kudep/Diplom_Accommodometer/annotation.tex

\likechapter{Аннотация}

В  выпускной  квалификационной  работе рассмотрено проектирование автоматизированной системы измерения и тренировки аккомодации глаз. Целью работы является создание системы, которая вкупе с законченной конструкционной базой, будет конкурентноспособоным прибором на рынке целевой аудитории. В начале осветим общие понятия, поставим задачу, далее рассмотрим имеющиеся выбор компонентов, сформируем компонентную базу, в последующей главе представлены электрические схемы и в конце работы приведем алгоритмическую часть функциональных частей операционной системы, представленных в графах.
