kudep/Diplom_Accommodometer/title.tex

\begin{titlepage}
\newpage

\begin{center}
МИНИСТЕРСТВО ОБРАЗОВАНИЯ И НАУКИ РОССИЙСКОЙ ФЕДЕРАЦИИ 
ФЕДЕРАЛЬНОЕ ГОСУДАРСТВЕННОЕ АВТОНОМНОЕ ОБРАЗОВАТЕЛЬНОЕ 
УЧРЕЖДЕНИЕ \\*
\vspace{1em}
«Национальный исследовательский ядерный университет «МИФИ»\\*
\hrulefill
\end{center}

\vspace{0.5em}

\begin{center}
 
Факультет очно-заочного (вечернего) обучения\\
Кафедра 27\\
«Микро- и наноэлектроники»\\
\end{center}

\vspace{0.5em}

\begin{center}
ПОЯСНИТЕЛЬНАЯ ЗАПИСКА\\
к выпускной квалификационной работе\\
по направлению 140800 – Ядерные физика и технологии\\
на тему:
\end{center}

\vspace{0.5em}

\begin{center}
\textsc{Автоматизированная система измерения и тренировки аккомодации глаз}
\end{center}

\vspace{1em}
 
\begin{center}

Студент:\hspace{3.45cm} \underline{\hspace{6cm}} \hspace{\fill}(\_Кузнецов Д.П.\_)\\ 
\vspace{1em}
 
Руководитель:\hspace{2.2cm} \underline{\hspace{6cm}} \hspace{\fill}(\_Саруханов В.А.\_)\\  
\vspace{1em}
 
Рецензент:\hspace{3.05cm} \underline{\hspace{6cm}} \hspace{\fill}(\_Коблов К.Ю.\_)\\ 
\vspace{1em}
 
Заведующий кафедрой:\hspace{0.2cm} \underline{\hspace{6cm}} \hspace{\fill}(\_Першенков В.С\_)\\ 
\vspace{1em}
 
Оценка ГЭК\hspace{2.65cm} \underline{\hspace{6cm}} \hspace{\fill}(\underline{\hspace{4cm}})\\
\begin{footnotesize}
\hspace{\fill}\underline{\hspace{0.3cm}}расшифровка подписи\underline{\hspace{0.3cm}}\\
\end{footnotesize}
Секретарь ГЭК\hspace{2.05cm} \underline{\hspace{6cm}} \hspace{\fill}(\underline{\hspace{4cm}})\\ 

\begin{footnotesize}
\hspace{\fill}\underline{\hspace{0.3cm}}расшифровка подписи\underline{\hspace{0.3cm}}\\
\end{footnotesize}

\end{center}
 
\vspace{\fill}

\begin{center}
\today
\end{center}

\begin{center}
Москва
\end{center}

\end{titlepage}
