kudep/Diplom_Accommodometer/pendant_A.tex

\likechapter{Приложение А}

\begin{figure}[ht]
	\centering
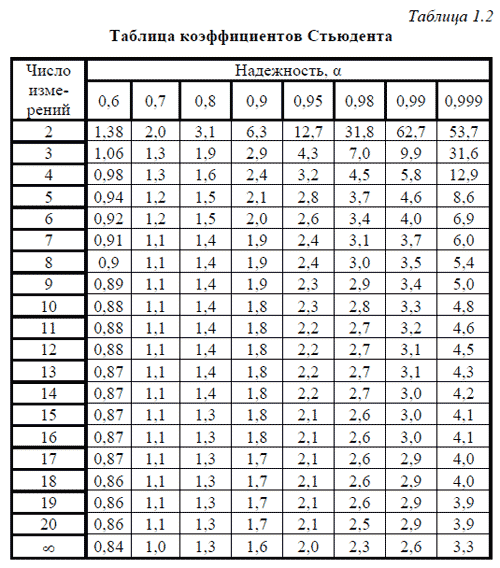
[picture p1: images/student_table.png]
	
	\caption{Таблица коэффициентов Стьюдента.}
	\label{fig:TestObjC}
\end{figure}
\includepdf[pages=1-2,scale=2.035,offset=0mm 0mm,pagecommand={}]{BoardSchem.pdf}
