kudep/Diplom_Accommodometer/Aut_Sys_M_T_Acc_Eyes.tex

\include{preamble}

\begin{document}

\include{title}

\include{annotation}

\newpage\tableofcontents % это 1оглавление, которое генерируется автоматически

\include{glossary}

\include{introduction}

\include{lit_review}

\include{component_base}

\include{hardware}

\include{OS}

\include{end}

\bibliographystyle{utf8gost705u}  %% стилевой файл для оформления по ГОСТу
\bibliography{biblio}     %% имя библиографической базы (bib-файла)

\include{pendant_A}

\include{pendant_B}

\end{document}
