kudep/Diplom_Accommodometer/end.tex

\likechapter{Заключение}
В результате дипломной работы была создана автоматизированная система измерения и тренировки аккомодации глаз. В рамках дипломной работы поставленная задача выполнена, по мере ее создания было использовано много интересных решений (подавление помех сигнала энкодера, создание напряжение для передачи сигнала цвета VGA, организация ОС и т.д.). При углублении в тему проекта со стороны заказчика было встречено и принято несколько расширяющих задач (подключение USB HUB, отображение на мониторе тест-картинок и т.д.).

На данном этапе заказчик создает для разработанной системы конструкцию, которая заменит макетную платформу, в тоже время идет отладка программного обеспечения и разработка печатной платы и решение других задач, нацеленные на приведение проекта к завершающей стадии готового продукта.
