kudep/Diplom_Accommodometer/pendant_B.tex

\likechapter{Приложение В}

Приведен класс с помощью которого создаются элементы графического интерфейса.
\begin{verbatim}

#ifndef CNTRLSUBGROUP_H_INCLUDED
#define CNTRLSUBGROUP_H_INCLUDED
#include <VGA.h>
#include <string.h>
#include "intrfsubgroup.h"

class CntrlSubGroup
{
public:
	CntrlSubGroup(Color_Style style, Metric_Parameters metric) 
	:ISG(IntrfSubGroup_Init_Parameters(style, metric, &state, text)), 
	metric(metric), state(false), modification(false){};
	CntrlSubGroup(Color_Style style, Metric_Parameters metric, 
	const char*_text) :ISG(IntrfSubGroup_Init_Parameters(style,
	 metric, &state, text)), metric(metric), state(false), 
	 modification(false){ strcpy_center_text(_text); };
	CntrlSubGroup(Color_Style style, Metric_Parameters metric, 
	int _text) :ISG(IntrfSubGroup_Init_Parameters(style, metric, 
	&state, text)), metric(metric), state(false), modification(false)
	{ strcpy_center_text(_text); };
	CntrlSubGroup();
	~CntrlSubGroup();
	void refresh();
	void update();
	bool strcpy_center_text(const char* _text);
	bool strcpy_center_text(int _ntext);
	bool strcpy_text(const char* _text);
	bool strcpy_text(int _ntext);
	void enable();
	void disable();
	void state_switch();

private:
	void add_space(int n);
	void itoa(int n, char s[]);
	void reverse(char s[]);
	static const int string_length = 30;
	IntrfSubGroup ISG;
	Metric_Parameters metric;
	IntrfSubGroup_State state;
	char text[string_length];
	bool modification;
};
#endif

#include"cntrlsubgroup.h"

CntrlSubGroup::CntrlSubGroup()
{
}

CntrlSubGroup::~CntrlSubGroup()
{
}
void CntrlSubGroup::refresh()
{
	ISG.update();
	modification = false;
}
void CntrlSubGroup::update()
{
	if (modification)ISG.update();
	modification = false;
}
bool CntrlSubGroup::strcpy_center_text(const char*_text)
{
	if (metric.height*metric.width > strlen(_text))
	{
		if (metric.height == 1)
		{
			add_space((metric.width - strlen(_text)) / 2);
			strcat(text, _text);
		}
		else
			strcpy(text, _text);
		modification = true;
		return true;
	}
	else
		return false;
}
bool CntrlSubGroup::strcpy_center_text(int _ntext)
{
	char _text[string_length];
	itoa(_ntext, _text);
	if (metric.height*metric.width > strlen(_text) + 1)
	{
		if (metric.height == 1)
		{
			add_space((metric.width - strlen(_text)) / 2);
			strcat(text, _text);
		}
		else
			strcpy(text, _text);
		modification = true;
		return true;
	}
	else
		return false;
}
bool CntrlSubGroup::strcpy_text(const char*_text)
{
	if (metric.height*metric.width > strlen(_text))
	{
		strcpy(text, _text);
		modification = true;
		return true;
	}
	else
		return false;
}
bool CntrlSubGroup::strcpy_text(int _ntext)
{
	char _text[string_length];
	itoa(_ntext, _text);
	if (metric.height*metric.width > strlen(_text)) 
	{
		strcpy(text, _text);
		modification = true;
		return true;
	}
	else
		return false;
}
void CntrlSubGroup::enable()
{
	state.enable();
	modification = true;
}
void CntrlSubGroup::disable()
{
	state.disable();
	modification = true;
}
void CntrlSubGroup::state_switch()
{
	state.reverse();
	modification = true;
}
void CntrlSubGroup::add_space(int n)
{
	for (size_t i = 0; i < n; i++)
		text[i] = ' ';
	text[n] = 0;
}
void CntrlSubGroup::itoa(int n, char s[])
{
	int i, sign;

	if ((sign = n) < 0)  /* записываем знак */
		n = -n;          /* делаем n положительным числом */
	i = 0;
	do {       /* генерируем цифры в обратном порядке */
		s[i++] = n % 10 + '0';   /* берем следующую цифру */
	} while ((n /= 10) > 0);     /* удаляем */
	if (sign < 0)
		s[i++] = '-';
	s[i] = '\0';
	reverse(s);
}
void CntrlSubGroup::reverse(char s[])
{
	int i, j;
	char c;

	for (i = 0, j = strlen(s) - 1; i<j; i++, j--) {
		c = s[i];
		s[i] = s[j];
		s[j] = c;
	}
}
\end{verbatim}
