kudep/Diplom_Accommodometer/preamble.tex

\documentclass[a4paper,14pt,russian]{extreport}
 
\usepackage{extsizes}
\usepackage{cmap} % для кодировки шрифтов в pdf
\usepackage[T2A]{fontenc}
\usepackage[utf8]{inputenc}
\usepackage[russian]{babel}
%\usepackage{pscyr}
  
\usepackage{graphicx} % для вставки картинок

%Поворачиваем рисунок вместе с подписью на 90 гр.:
\usepackage{rotating} 
\usepackage{epsfig}

\usepackage{amssymb,amsfonts,amsmath,amsthm} % математические дополнения от АМС
\usepackage{indentfirst} % отделять первую строку раздела абзацным отступом тоже
\usepackage[usenames,dvipsnames]{color} % названия цветов
\usepackage{makecell}
\usepackage{multirow} % улучшенное форматирование таблиц
\usepackage{ulem} % подчеркивания
 
\linespread{1.3} % полуторный интервал
%\renewcommand{\rmdefault}{ftm} % Times New Roman
\frenchspacing

%Форматирование подписей таблиц и картинок
\usepackage[tableposition=top]{caption}
\usepackage{subcaption}
\DeclareCaptionLabelFormat{gostfigure}{Рисунок #2}
\DeclareCaptionLabelFormat{gosttable}{Таблица #2}
\DeclareCaptionLabelSeparator{gost}{~---~}
\captionsetup{labelsep=gost}
\captionsetup[figure]{labelformat=gostfigure}
\captionsetup[table]{labelformat=gosttable}
\renewcommand{\thesubfigure}{\asbuk{subfigure}}
\graphicspath{{images/}}

%Форматирование заголовков
\usepackage{titlesec}
 
\titleformat{\chapter}[display]
    {\filcenter}
    {\MakeUppercase{\chaptertitlename} \thechapter}
    {8pt}
    {\bfseries}{}
 
\titleformat{\section}
    {\normalsize\bfseries}
    {\thesection}
    {1em}{}
 
\titleformat{\subsection}
    {\normalsize\bfseries}
    {\thesubsection}
    {1em}{}
 
% Настройка вертикальных и горизонтальных отступов
\titlespacing*{\chapter}{0pt}{-30pt}{8pt}
\titlespacing*{\section}{\parindent}{*4}{*4}
\titlespacing*{\subsection}{\parindent}{*4}{*4}

%Настройки страниц
\usepackage{geometry}
\geometry{left=3cm}
\geometry{right=1.5cm}
\geometry{top=2.4cm}
\geometry{bottom=2.4cm}

%Настройка списков
\usepackage{enumitem}
\makeatletter
    \AddEnumerateCounter{\asbuk}{\@asbuk}{м)}
\makeatother
\setlist{nolistsep}
\renewcommand{\labelitemi}{-}
\renewcommand{\labelenumi}{\asbuk{enumi})}
\renewcommand{\labelenumii}{\arabic{enumii})}

%Настройка оглавления
\usepackage{tocloft}
\renewcommand{\cfttoctitlefont}{\hspace{0.38\textwidth} \bfseries\MakeUppercase}
\renewcommand{\cftbeforetoctitleskip}{-1em}
\renewcommand{\cftaftertoctitle}{\mbox{}\hfill \\ \mbox{}\hfill{\footnotesize Стр.}\vspace{-2.5em}}
\renewcommand{\cftchapfont}{\normalsize\bfseries \MakeUppercase{\chaptername} }
\renewcommand{\cftsecfont}{\hspace{31pt}}
\renewcommand{\cftsubsecfont}{\hspace{11pt}}
\renewcommand{\cftbeforechapskip}{1em}
\renewcommand{\cftparskip}{-1mm}
\renewcommand{\cftdotsep}{1}
\setcounter{tocdepth}{2} % задать глубину оглавления — до subsection включительно

%Библиотека позволяющая выполнять подсчет страниц
%\usepackage(lastpage)

%Специальные разделы (аннотация, вступление, список сокращений, выводы, список литературы)
%Мы не ищем легких путей. Я решил создать свой собственный вид секции. Как оказалось, это не так-то и сложно.
%Чтобы определить секцию (я назвал её likechapter), для начала стоит определить соответствующую оформляющую команду. Оформить центрирование и капитализацию названия секции — раз плюнуть. Что я и сделал — команда \likechapterheading печатает как надо переданное ей название секции.
\newcommand{\empline}{\mbox{}\newline}
\newcommand{\likechapterheading}[1]{ 
	\newpage
    \begin{center}
    \textbf{\MakeUppercase{#1}}
    \end{center}
    \empline}
    
% определение заголовка \likechapter    
\makeatletter
    \renewcommand{\@dotsep}{2}
    \newcommand{\l@likechapter}[2]{{\bfseries\@dottedtocline{0}{0pt}{0pt}{#1}{#2}}}
\makeatother
\newcommand{\likechapter}[1]{    
    \likechapterheading{#1}    
    \addcontentsline{toc}{likechapter}{\MakeUppercase{#1}}}

% Список литературы   
\usepackage[square,numbers,sort&compress]{natbib}
\renewcommand{\bibnumfmt}[1]{#1.\hfill} % нумерация источников в самом списке — через точку
\renewcommand{\bibsection}{\likechapter{Список литературы}} % заголовок специального раздела
\setlength{\bibsep}{0pt}

%Вставк pdf файлов
\usepackage{pdfpages}
\newcommand{\append}[1]{ 
    \clearpage
    \stepcounter{chapter}    
    \paragraph{\MakeUppercase{#1}}
   \empline
    \addcontentsline{toc}{likechapter}{\MakeUppercase{\chaptertitlename~\Asbuk{chapter}\;#1}}}
