kudep/Diplom_Accommodometer/images/apparats_shcem_of_sys_graf.jpg

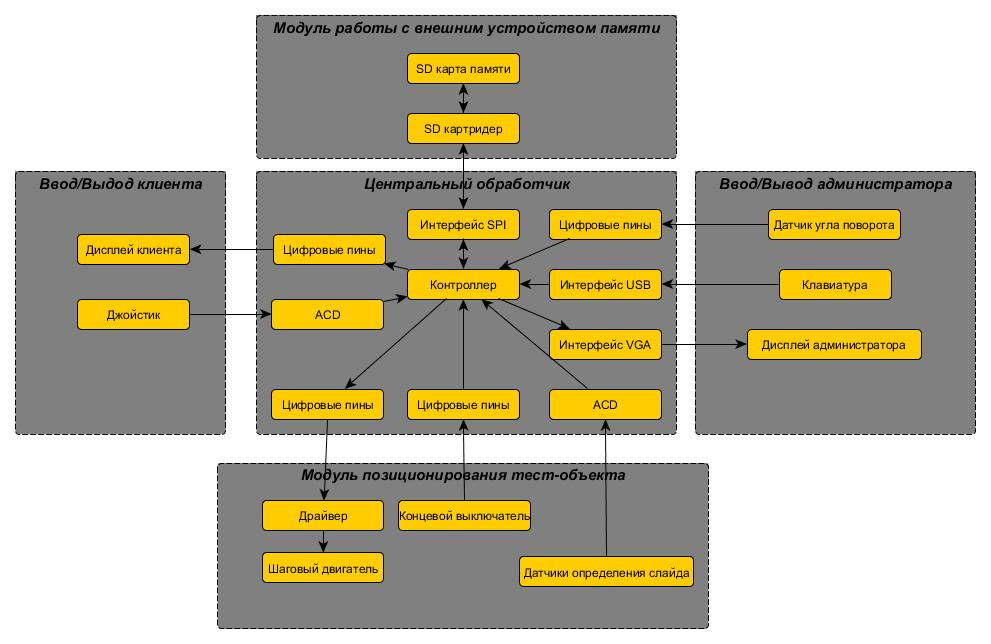
images/apparats_shcem_of_sys_graf.jpg
