kudep/Diplom_Accommodometer/BoardSchem.pdf

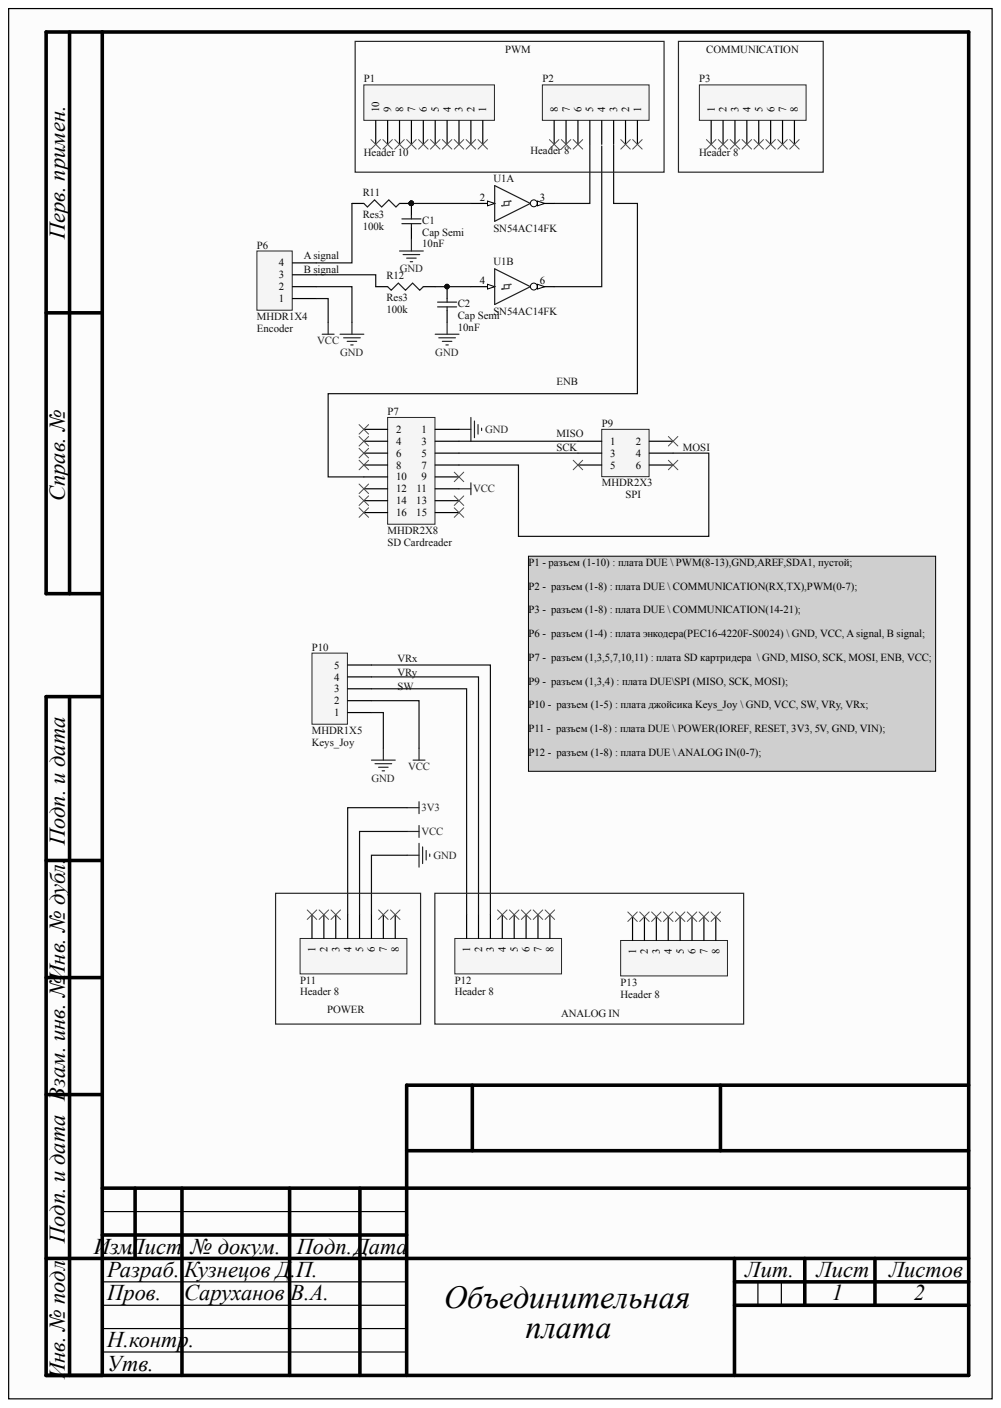
[picture p36: page 1]

Подп. и дата Перв. примен. Справ. №

Р1 - разъем (1-10) : плата DUE \ PWM(8-13),GND,AREF,SDA1, пустой;

Р2 - разъем (1-8) : плата DUE \ COMMUNICATION(RX,TX),PWM(0-7);

Р3 - разъем (1-8) : плата DUE \ COMMUNICATION(14-21);

Р6 - разъем (1-4) : плата энкодера(PEC16-4220F-S0024) \ GND, VCC, A signal, B signal;

Р7 - разъем (1,3,5,7,10,11) : плата SD картридера \ GND, MISO, SCK, MOSI, ENB, VCC;

Р9 - разъем (1,3,4) : плата DUE\SPI (MISO, SCK, MOSI);

Р10 - разъем (1-5) : плата джойсика Keys_Joy \ GND, VCC, SW, VRy, VRx;

Р11 - разъем (1-8) : плата DUE \ POWER(IOREF, RESET, 3V3, 5V, GND, VIN);

Р12 - разъем (1-8) : плата DUE \ ANALOG IN(0-7);

бл. Подп. и дата Взам. инв. №

Инв. № подл. Инв. № ду

Разраб. | Кузнецов Д.П. | Объединительная плата | Лит. | Лист | Листов
Пров. | Саруханов В.А. | | | | | 1 | 2

Н.контр.
Утв.

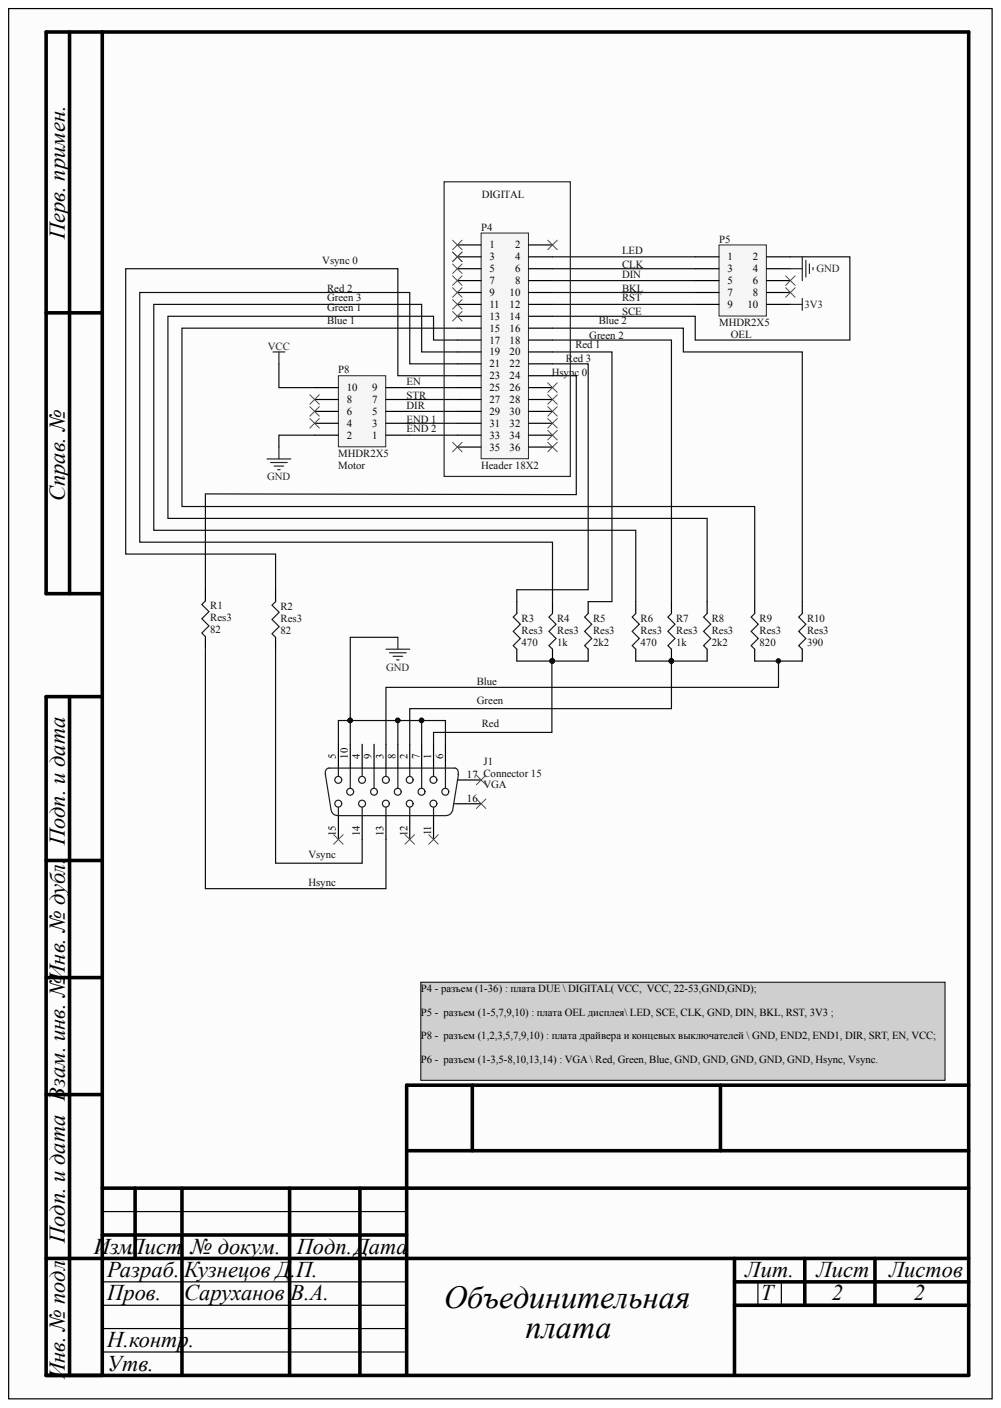
[picture p37: page 2]

Подп. и дата Перв. примен. Справ. №

CLK
DIN
BKL RST

Green 1 Green 3 Red 2

SCE

Red 3
Hsync 0

STR
DIR
END 1 END 2

бл. Подп. и дата Взам. инв. №

Инв. № подл. Инв. № ду

Р4 - разъем (1-36) : плата DUE \ DIGITAL( VCC, VCC, 22-53,GND,GND);

Р5 - разъем (1-5,7,9,10) : плата OEL дисплея\ LED, SCE, CLK, GND, DIN, BKL, RST, 3V3 ;

Р8 - разъем (1,2,3,5,7,9,10) : плата драйвера и концевых выключателей \ GND, END2, END1, DIR, SRT, EN, VCC;

Р6 - разъем (1-3,5-8,10,13,14) : VGA \ Red, Green, Blue, GND, GND, GND, GND, GND, Hsync, Vsync.

Разраб. | Кузнецов Д.П. | Объединительная плата | Лит. | Лист | Листов
Пров. | Саруханов В.А. | | | Т | | 2 | 2

Н.контр.
Утв.
