kudep/Diplom_Accommodometer/(list of files, drawings)

Other design files:
apparatus/Aut_Sys_M_T_Acc_Eyes.PrjPCB
apparatus/unifying.SchDoc
apparatus/unifying_sht1.SchDoc
apparatus/unifying_sht2.SchDoc
