kudep/Diplom_Accommodometer/(commit log)

2016-01-19 Дипломная работа на тему "Автоматизированная система измерения и тренировки аккомодации глаза" Написанно 10 страниц, в их число входит: титульный лист аннотация глоссарий содержание введение литобзор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
2016-01-19 Добавленны единыцы измерения глубины аккомодации(диоптрии) в первую таблицу
2016-01-20 Написанна половина 2-й главы(Компонентная база), исправленны ошибки в предведущем тексте
2016-01-21 Началась редакция 1.4 постановка задачи(подправленны графы, добавленны новые), добавленны комментарии к подразделам глаф, выделенны курсивом. Началось описание детекторов диапозитивов
2016-01-23 Написанна 3 глава(Компонентная база)
2016-01-26 Диплом дописанн, прошел проверку на орфоргафию и синтаксис
    [Aut_Sys_M_T_Acc_Eyes.PrjPCB, unifying.SchDoc, unifying_sht1.SchDoc, unifying_sht2.SchDoc]
2016-01-26 Исправлнен код направление специальности
2016-05-24 Корректировка для стабильной работе на Linux, добавление стилевого файла списка литературы
